johonkanen/ac_psu_gate_drive/source/schematic_pdf/schematic_text.txt

                                                               drv1_vcc

                                           DRV1
                                       1                        8
pwm_hi                                      Vin        VDD2
                                                                     D1+
                                                                            R12
                                       2                        7
            5v                              VDD1       OUT+                22R
                                                                                                       Gate_HI
            R1                         3
                                            GND1        OUT-
                                                                6    D1-
                                                                            R2
            10k        C6
                       100n                                                3R
                                       4                        5
                                            EN         GND2
                                                                                                 R6                                    J9
                                                                                                 10k
                                                                                                                                  16          15
                                           SI8271
                                                                                                                                  18          17
                                                                                                                 SOURCE_HI                                SOURCE_HI
                                 GND                                                                                              20          19
                                                    DRV1_RET
                                                                                                                                  22          21
                                                                                                                                  24          23
                                                                                                                   GATE_HI                                GATE_HI
                                                                                                                                  26          25

                                                               drv2_vcc                                                           30          29
                                                                                  SOURCE_HI
                                                                                                                                  32          31
                                           DRV2                                                                       Source_LO                           Source_LO
                                                                                                                                  34          33
                                                                                                                                  36          35
                                       1                        8
   pwm_lo                                   Vin        VDD2                                                                       38          37
                                                                                                                       Gate_LO                            Gate_LO
                                                                     D2+
                                                                           R4                                                     40          39
                                       2                        7
             5v                             VDD1       OUT+                22R                                                    44          43
                                                                                                       Gate_LO        PWM_HI                             PWM_LO
                                                                          R5                                                      46          45
                 R3                    3
                                            GND1        OUT-
                                                                6     D2-                                                 5v
                                                                                                                                  48          47
                                                                                                                                                         GND
                 10k          C5                                                                                   PWM_TRANS                             15V
                              100n                                         3R
                                       4                        5                                                                      HB GT CONNECTOR
                                            EN         GND2
                                                                                                 R8
                                           SI8271                                                10k

                                 GND

                                                               DRV2_RET
                                                                                     SOURCE_LO

                                                        DRV1_VCC
                  J3            D3
                          1

                  PIN           ZLLS400TA
                                                   D7            C1
                                                               4.7u
                  J5                               MMSZ5228BS-7-F
                          1                                                                                       R9
                                                                                             SOURCE_HI            10k
                  PIN
                                                   D8            C2
                  J4           D4                              4.7u
                                                   MMSZ5228BS-7-F
                          1

                  PIN          ZLLS400TA

                                                        DRV1_RET

                                                        DRV2_VCC
                  J6           D1
                          1                                                                                                            gate power supply transformer
                  PIN          ZLLS400TA
                                                                                                                                        toroid 10/6/4
                                                D6               C4                                                                                       12t   J3
                                                                 4.7u
                  J8                            MMSZ5228BS-7-F
                          1
                                                                                             SOURCE_LO            R10
                                                                                                                  10k                                           J4
                  PIN
                                           D5                    C3
                  J7          D2                                 4.7u                                                                  J1
                                           MMSZ5228BS-7-F                                                                                      8t
                          1
                                                                                                                                                           4t   J5
                  PIN         ZLLS400TA
                                                        DRV2_RET                                                                                          12t
                                                                                                                                       J2                       J6

                                                                                                                                                                J7
                                                                                                                                                          4t
            15V                                                                                                                                                 J8
                                                                                                           DRV3
                                                                             8

                                                                                         1
                                                                                 VCC

                                                                                             VCC

                                                                                                                      J1
                                                                  2                                         7     1
pwm_trans                                                               IN                          OUTA                        J2
                                                                                                                      PIN       PIN

                                                                                                                            1
                                                                  3                                         6
                                            R11                         EN                          OUTB
                                                                             GND
                                                                                       GND

                   C7         C8
                                                                                              TAB

                                            10k
                   4.7u       100n                                                                                              C12
                                                                                                    IXDD609D2TR                 100n
                                                                             4
                                                                                   5
                                                                                             9

            GND
