johonkanen/ac_psu_gate_drive/dcm/reference/pins_by_net.md

# Pins by net

Generated by `p2k ipc356`. Do not edit. Nets with a single pin are
usually test points or connections made through the ignored-by-IPC copper.

`vias` counts vias and free pads (blank refdes with a net).

| net | pins | vias | members |
|---|---|---|---|
| 5V | 7 | 0 | C5-2 C6-2 DRV1-2 DRV1-4 DRV2-2 DRV2-4 J9-46 |
| 15V | 5 | 2 | C8-2 C9-1 J1-1 J9-47 R14-1 |
| #00038 | 2 | 0 | D1-A J6-1 |
| #00039 | 2 | 0 | D2-C J7-1 |
| #00040 | 2 | 0 | D3-A J3-1 |
| #00041 | 2 | 0 | D4-C J4-1 |
| #00043 | 3 | 0 | J2-1 Q1-3 R7-2 |
| #00046 | 2 | 0 | Q1-1 R11-2 |
| #00047 | 3 | 0 | C9-2 D9-C R14-2 |
| #00048 | 2 | 0 | D9-A R7-1 |
| D1+ | 2 | 0 | DRV1-7 R12-1 |
| D1- | 2 | 0 | DRV1-6 R2-1 |
| D2+ | 2 | 0 | DRV2-7 R4-1 |
| D2- | 2 | 0 | DRV2-6 R5-1 |
| DRV1_RET | 5 | 2 | C2-2 D4-A D8-A DRV1-5 R9-2 |
| DRV1_VCC | 6 | 2 | C1-1 D3-C D7-C DRV1-8 J9-26 R9-1 |
| DRV2_RET | 5 | 2 | C3-2 D2-A D5-A DRV2-5 R10-2 |
| DRV2_VCC | 6 | 2 | C4-1 D1-C D6-C DRV2-8 J9-40 R10-1 |
| GATE_HI | 8 | 0 | J9-21 J9-22 J9-23 J9-24 J9-25 R2-2 R6-1 R12-2 |
| GATE_LO | 8 | 0 | J9-35 J9-36 J9-37 J9-38 J9-39 R4-2 R5-2 R8-1 |
| GND | 10 | 3 | C5-1 C6-1 C8-1 DRV1-3 DRV2-3 J9-45 Q1-2 R1-2 R3-2 R13-2 |
| PWM_HI | 3 | 1 | DRV1-1 J9-44 R1-1 |
| PWM_LO | 3 | 0 | DRV2-1 J9-43 R3-1 |
| PWM_TRANS | 3 | 0 | J9-48 R11-1 R13-1 |
| SOURCE_HI | 12 | 1 | C1-2 C2-1 D7-A D8-C J5-1 J9-15 J9-16 J9-17 J9-18 J9-19 J9-20 R6-2 |
| SOURCE_LO | 12 | 1 | C3-1 C4-2 D5-C D6-A J8-1 J9-29 J9-30 J9-31 J9-32 J9-33 J9-34 R8-2 |
