johonkanen/ac_psu_gate_drive/dcm/reports/render/01_gate_drivers.png

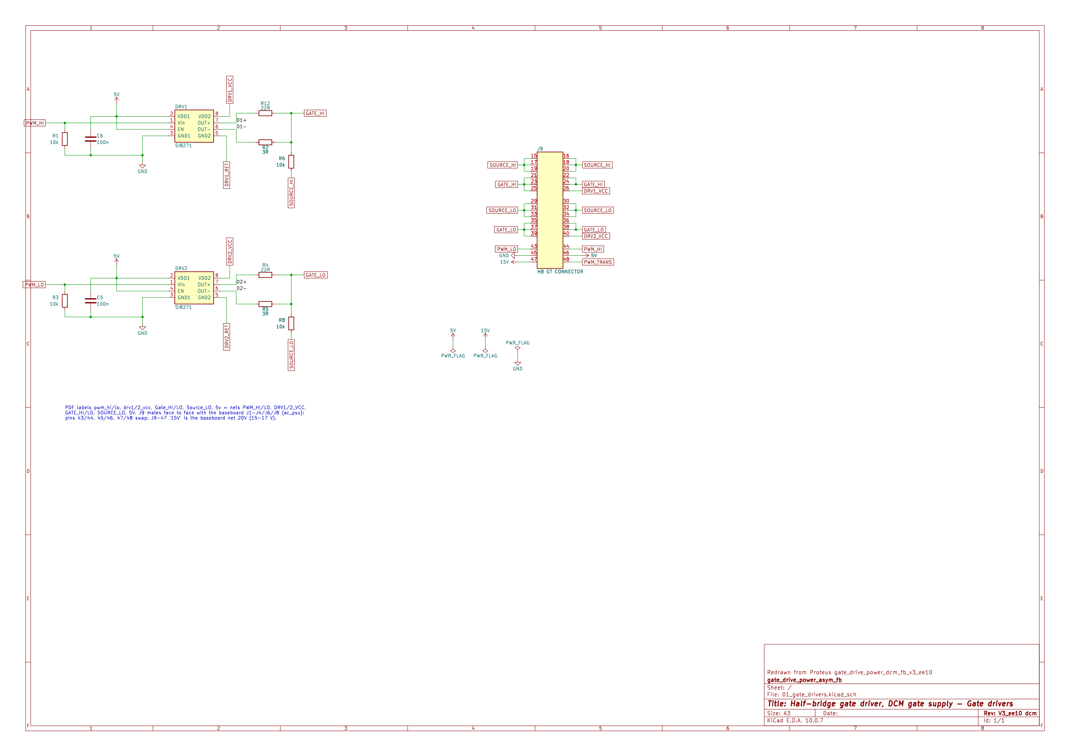
dcm/reports/render/01_gate_drivers.png
