johonkanen/ac_psu_gate_drive/dcm/reports/render/02_gate_supply.png

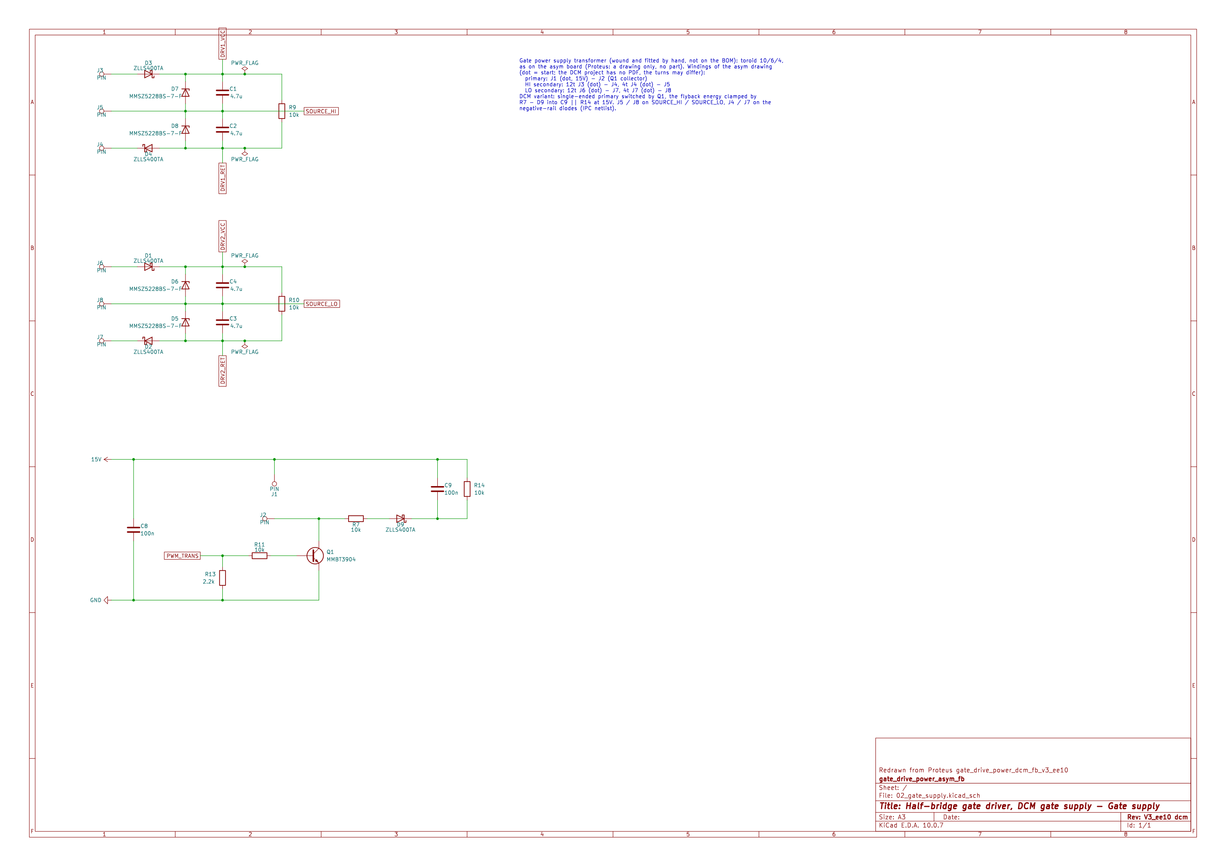
dcm/reports/render/02_gate_supply.png
