johonkanen/ac_psu_gate_drive/dcm/reports/roundtrip/B_Cu.png

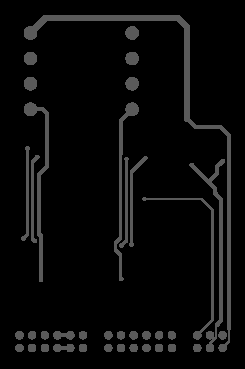
dcm/reports/roundtrip/B_Cu.png
