johonkanen/ac_psu_gate_drive/dcm/reports/roundtrip/F_Cu.png

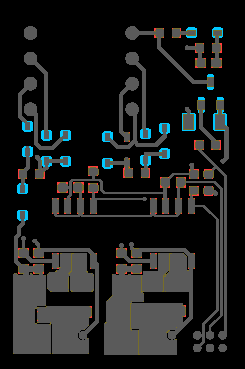
dcm/reports/roundtrip/F_Cu.png
