johonkanen/ac_psu_gate_drive/source/schematic_pdf/hi-1.png

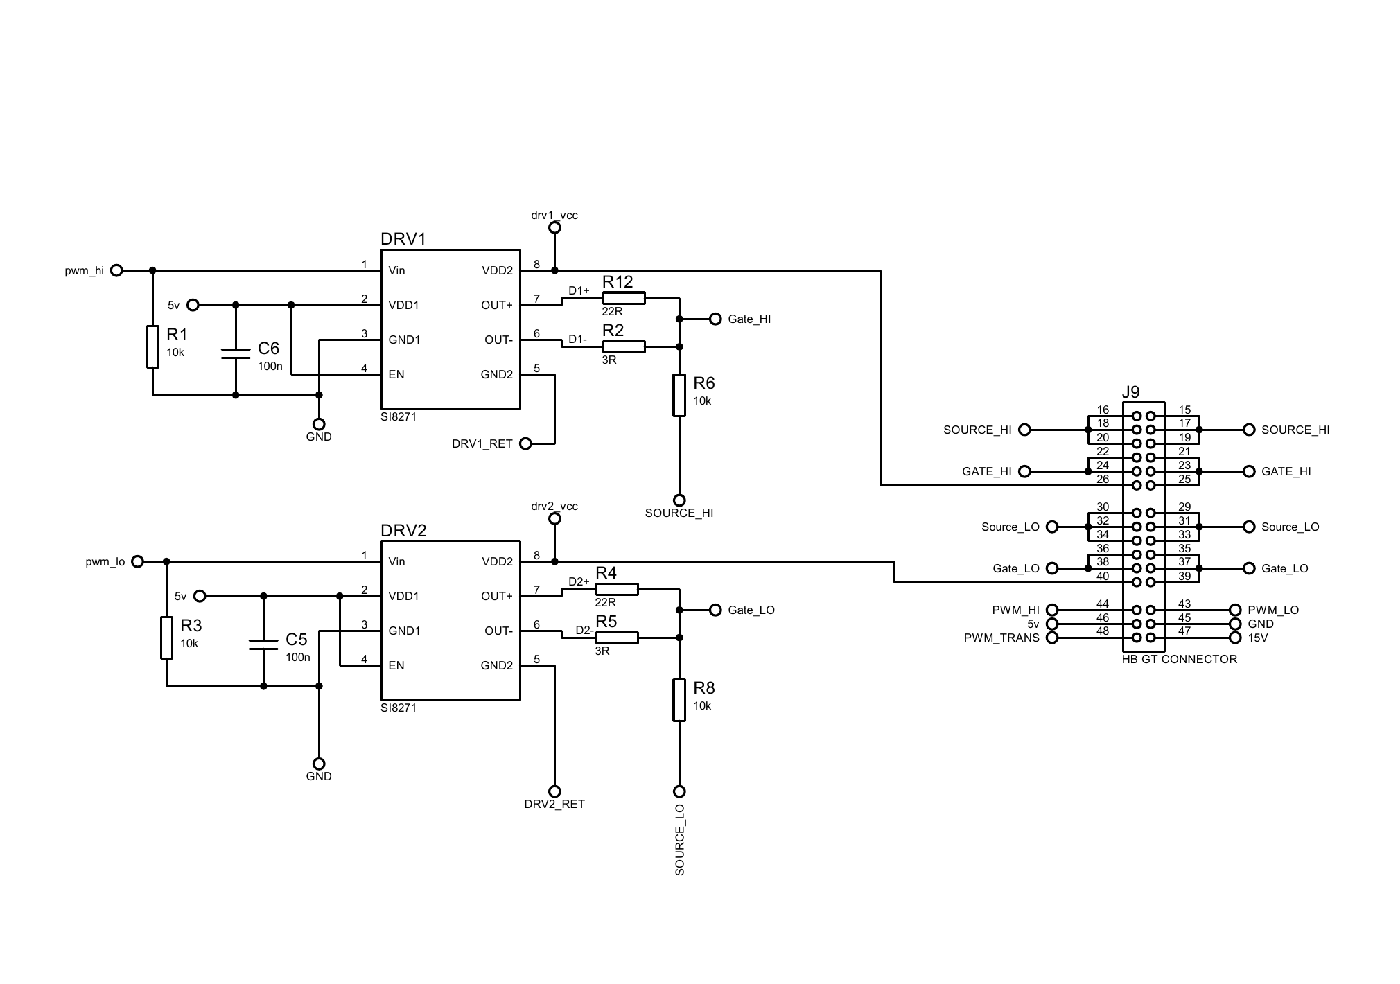
source/schematic_pdf/hi-1.png
