johonkanen/ac_psu_gate_drive/source/schematic_pdf/hi-2.png

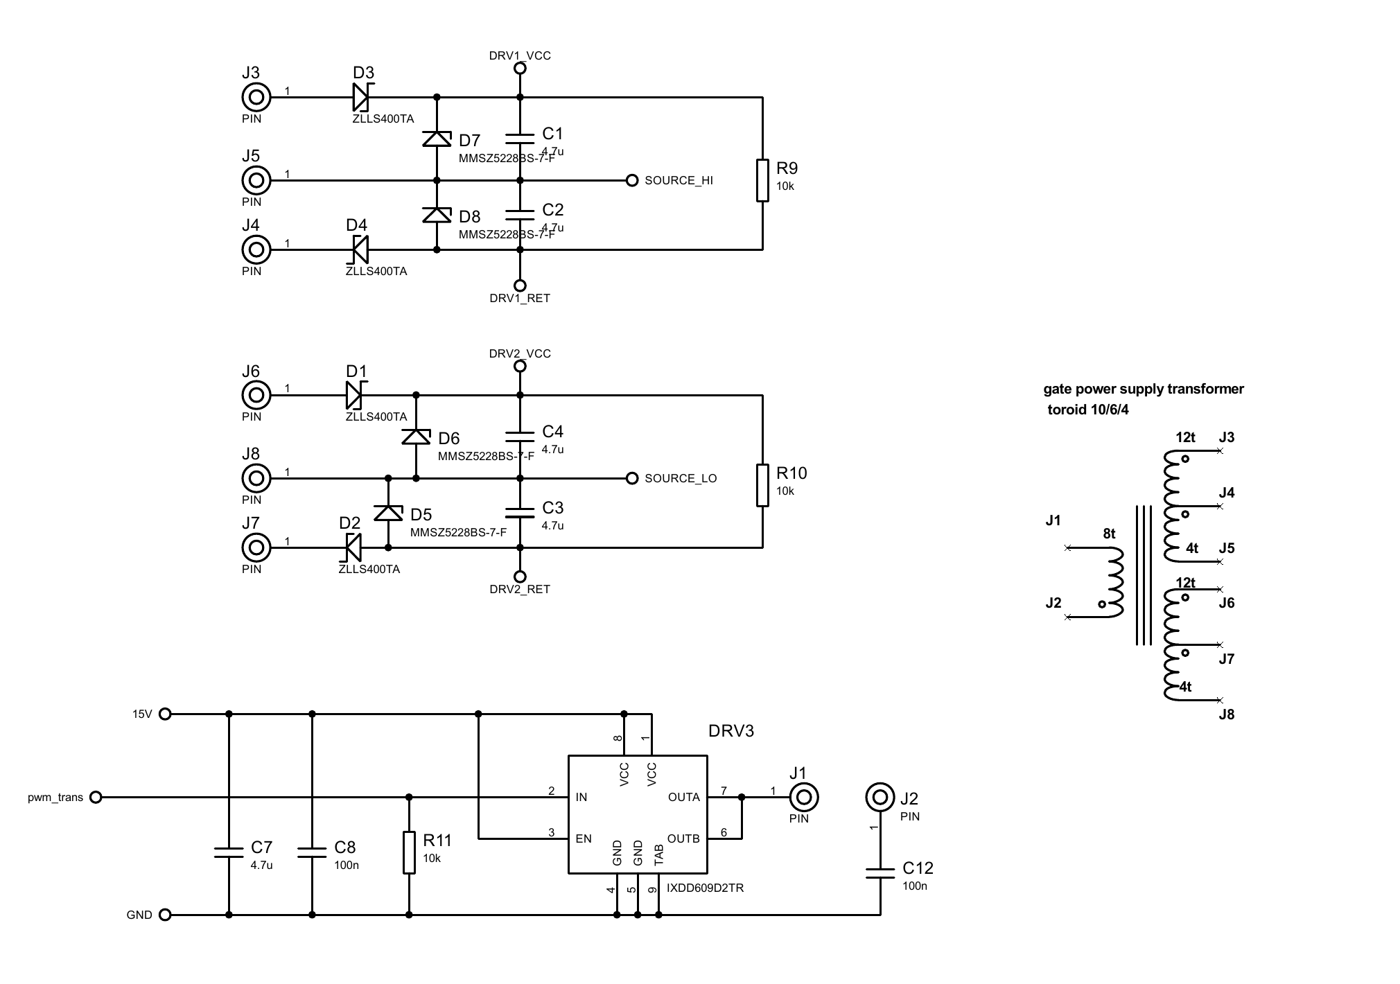
source/schematic_pdf/hi-2.png
