johonkanen/ac_psu_gate_drive/dcm/reference/pin_nets_by_component.md

# Pin → net by component

Generated by `p2k ipc356` from the Proteus IPC-D-356A netlist. Do not edit.

Net aliases: .
Refdes restored from 6-char truncation: .
`N/C` = explicitly unconnected in Proteus; `(no net)` = pad without any net record.
Coordinates in mm, IPC orientation (Y up). Side: top/bottom for SMD, both for THT.

Index: C (8), D (9), DRV (2), J (9), Q (1), R (14)

## C1

2 pads, SMD, side top

| pin | net | x | y |
|---|---|---|---|
| 1 | DRV1_VCC | -20.400 | 16.700 |
| 2 | SOURCE_HI | -20.400 | 15.100 |

## C2

2 pads, SMD, side top

| pin | net | x | y |
|---|---|---|---|
| 1 | SOURCE_HI | -21.900 | 15.100 |
| 2 | DRV1_RET | -21.900 | 16.700 |

## C3

2 pads, SMD, side top

| pin | net | x | y |
|---|---|---|---|
| 1 | SOURCE_LO | -12.100 | 15.100 |
| 2 | DRV2_RET | -12.100 | 16.700 |

## C4

2 pads, SMD, side top

| pin | net | x | y |
|---|---|---|---|
| 1 | DRV2_VCC | -10.600 | 16.700 |
| 2 | SOURCE_LO | -10.600 | 15.100 |

## C5

2 pads, SMD, side top

| pin | net | x | y |
|---|---|---|---|
| 1 | GND | -18.017 | 23.232 |
| 2 | 5V | -16.417 | 23.232 |

## C6

2 pads, SMD, side top

| pin | net | x | y |
|---|---|---|---|
| 1 | GND | -7.755 | 23.790 |
| 2 | 5V | -6.155 | 23.790 |

## C8

2 pads, SMD, side top

| pin | net | x | y |
|---|---|---|---|
| 1 | GND | -2.250 | 29.800 |
| 2 | 15V | -5.400 | 29.800 |

## C9

2 pads, SMD, side top

| pin | net | x | y |
|---|---|---|---|
| 1 | 15V | -4.200 | 35.700 |
| 2 | #00047 | -2.600 | 35.700 |

## D1

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

## R13

2 pads, SMD, side top

| pin | net | x | y |
|---|---|---|---|
| 1 | PWM_TRANS | -3.400 | 24.600 |
| 2 | GND | -3.400 | 22.872 |

## R14

2 pads, SMD, side top

| pin | net | x | y |
|---|---|---|---|
| 1 | 15V | -4.300 | 37.200 |
| 2 | #00047 | -2.572 | 37.200 |
