johonkanen/ac_psu_gate_drive/dcm/fab/jlc_bom.csv

Comment | Designator | Footprint | JLCPCB Part #
10k | R1,R3,R6,R7,R8,R9,R10,R11,R14 | 0603 | C25804
2.2k | R13 | 0603 | C4190
22R | R4,R12 | 1206 | C17958
3R | R2,R5 | 1206 | C17939
100nF 50V X7R | C5,C6,C9 | 0603 | C14663
4.7uF 25V X5R | C1,C2,C3,C4 | 0603 | C5360844
100nF 50V X7R | C8 | 1206 | C24497
ZLLS400TA | D1,D2,D3,D4,D9 | SOD-323 | C460267
MMSZ5228BS-7-F | D5,D8 | SOD-323 | C2895358
MMSZ5246BS-7-F | D6,D7 | SOD-323 | C151819
MMBT3904 | Q1 | SOT-23 | C20526
SI8271DB-ISR | DRV1,DRV2 | SOIC-8 | C461855
