johonkanen/ac_psu_gate_drive/dcm/reports/footprint_fit.csv

# IPC frame (mm | Y up): board = (x | y) + R(angle) . M . pad | M = mirror x for bottom. KiCad (Y down): SetPosition(kicad_x | kicad_y); bottom: Flip(pos | LEFT_RIGHT); then SetOrientationDegrees(kicad_orientation)
refdes | footprint | side | angle | x | y | kicad_x | kicad_y | kicad_orientation | max_residual | max_pad_size_diff | max_drill_diff | max_pad_axis_diff
C1 | Capacitor_SMD:C_0603_1608Metric | top | 270 | -20.4000 | 15.9000 | -20.4000 | -15.9000 | 270 | 0.0250 | 0.040 | 0.000 | 0
C2 | Capacitor_SMD:C_0603_1608Metric | top | 90 | -21.9000 | 15.9000 | -21.9000 | -15.9000 | 90 | 0.0250 | 0.040 | 0.000 | 0
C3 | Capacitor_SMD:C_0603_1608Metric | top | 90 | -12.1000 | 15.9000 | -12.1000 | -15.9000 | 90 | 0.0250 | 0.040 | 0.000 | 0
C4 | Capacitor_SMD:C_0603_1608Metric | top | 270 | -10.6000 | 15.9000 | -10.6000 | -15.9000 | 270 | 0.0250 | 0.040 | 0.000 | 0
C5 | Capacitor_SMD:C_0603_1608Metric | top | 0 | -17.2170 | 23.2320 | -17.2170 | -23.2320 | 0 | 0.0250 | 0.040 | 0.000 | 0
C6 | Capacitor_SMD:C_0603_1608Metric | top | 0 | -6.9550 | 23.7900 | -6.9550 | -23.7900 | 0 | 0.0250 | 0.040 | 0.000 | 0
C8 | Capacitor_SMD:C_1206_3216Metric_Pad1.33x1.80mm_HandSolder | top | 180 | -3.8250 | 29.8000 | -3.8250 | -29.8000 | 180 | 0.0125 | 0.309 | 0.000 | 0
C9 | Capacitor_SMD:C_0603_1608Metric | top | 0 | -3.4000 | 35.7000 | -3.4000 | -35.7000 | 0 | 0.0250 | 0.040 | 0.000 | 0
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
R8 | Resistor_SMD:R_0603_1608Metric | top | 180 | -11.2360 | 9.8000 | -11.2360 | -9.8000 | 180 | 0.0390 | 0.089 | 0.000 | 0
R9 | Resistor_SMD:R_0603_1608Metric | top | 180 | -21.1360 | 24.6000 | -21.1360 | -24.6000 | 180 | 0.0390 | 0.089 | 0.000 | 0
