johonkanen/ac_psu_gate_drive/dcm/reports/footprint_pads.csv

refdes | pad | residual | ipc_x | ipc_y | ipc_size | fp_size | d_long | d_short | axis_diff | ipc_drill | fp_drill
C1 | 1 | 0.0250 | -20.400 | 16.700 | 0.939x0.99 | 0.9x0.95 | -0.040 | -0.039 | 0
C1 | 2 | 0.0250 | -20.400 | 15.100 | 0.939x0.99 | 0.9x0.95 | -0.040 | -0.039 | 0
C2 | 1 | 0.0250 | -21.900 | 15.100 | 0.939x0.99 | 0.9x0.95 | -0.040 | -0.039 | 0
C2 | 2 | 0.0250 | -21.900 | 16.700 | 0.939x0.99 | 0.9x0.95 | -0.040 | -0.039 | 0
C3 | 1 | 0.0250 | -12.100 | 15.100 | 0.939x0.99 | 0.9x0.95 | -0.040 | -0.039 | 0
C3 | 2 | 0.0250 | -12.100 | 16.700 | 0.939x0.99 | 0.9x0.95 | -0.040 | -0.039 | 0
C4 | 1 | 0.0250 | -10.600 | 16.700 | 0.939x0.99 | 0.9x0.95 | -0.040 | -0.039 | 0
C4 | 2 | 0.0250 | -10.600 | 15.100 | 0.939x0.99 | 0.9x0.95 | -0.040 | -0.039 | 0
C5 | 1 | 0.0250 | -18.017 | 23.232 | 0.939x0.99 | 0.9x0.95 | -0.040 | -0.039 | 0
C5 | 2 | 0.0250 | -16.417 | 23.232 | 0.939x0.99 | 0.9x0.95 | -0.040 | -0.039 | 0
C6 | 1 | 0.0250 | -7.755 | 23.790 | 0.939x0.99 | 0.9x0.95 | -0.040 | -0.039 | 0
C6 | 2 | 0.0250 | -6.155 | 23.790 | 0.939x0.99 | 0.9x0.95 | -0.040 | -0.039 | 0
C8 | 1 | 0.0125 | -2.250 | 29.800 | 1.016x1.524 | 1.325x1.8 | +0.276 | +0.309 | 0
C8 | 2 | 0.0125 | -5.400 | 29.800 | 1.016x1.524 | 1.325x1.8 | +0.276 | +0.309 | 0
C9 | 1 | 0.0250 | -4.200 | 35.700 | 0.939x0.99 | 0.9x0.95 | -0.040 | -0.039 | 0
C9 | 2 | 0.0250 | -2.600 | 35.700 | 0.939x0.99 | 0.9x0.95 | -0.040 | -0.039 | 0
D1 | A | 0.0000 | -9.700 | 28.600 | 0.508x0.838 | 1x1 | +0.162 | +0.492
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
R8 | 2 | 0.0390 | -12.100 | 9.800 | 0.889x0.889 | 0.8x0.95 | +0.061 | -0.089
R9 | 1 | 0.0390 | -20.272 | 24.600 | 0.889x0.889 | 0.8x0.95 | +0.061 | -0.089
R9 | 2 | 0.0390 | -22.000 | 24.600 | 0.889x0.889 | 0.8x0.95 | +0.061 | -0.089
