johonkanen/ac_psu_gate_drive/source/schematic_pdf/gate_drive_power_asym_fb_v3_ee10.PDF

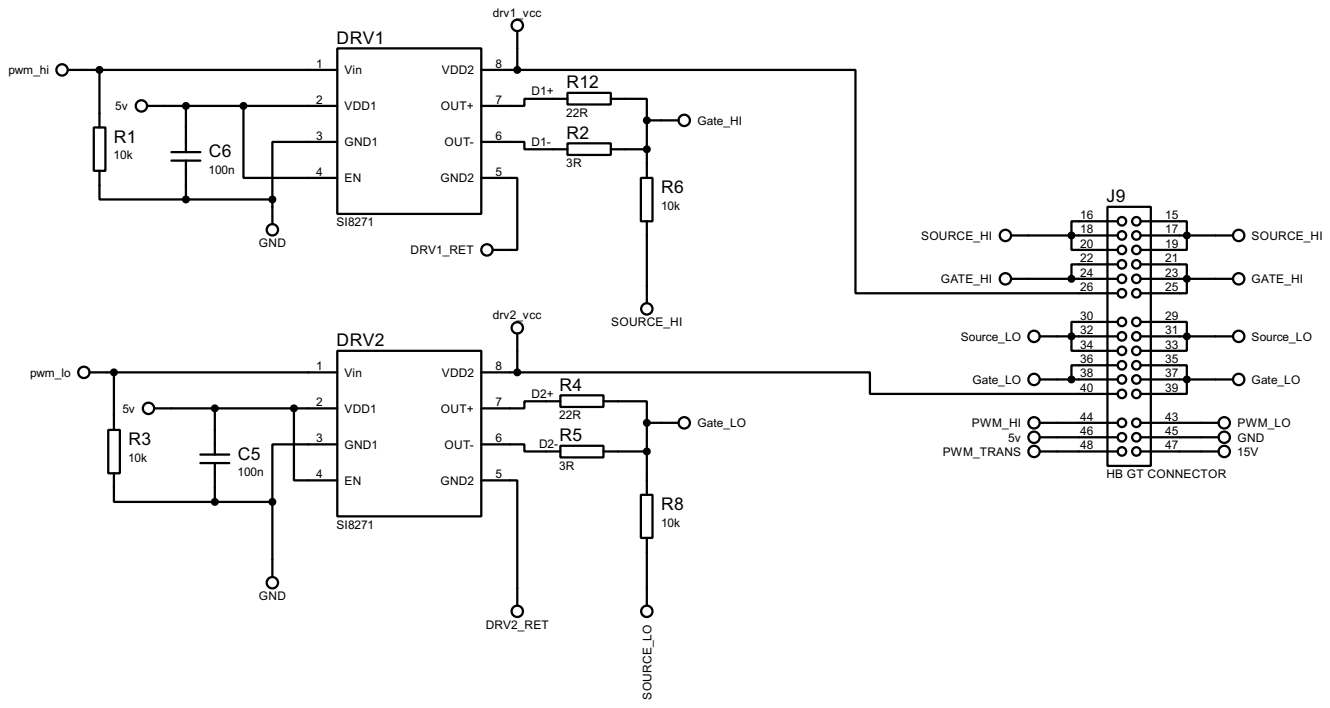
[picture p7: page 1]

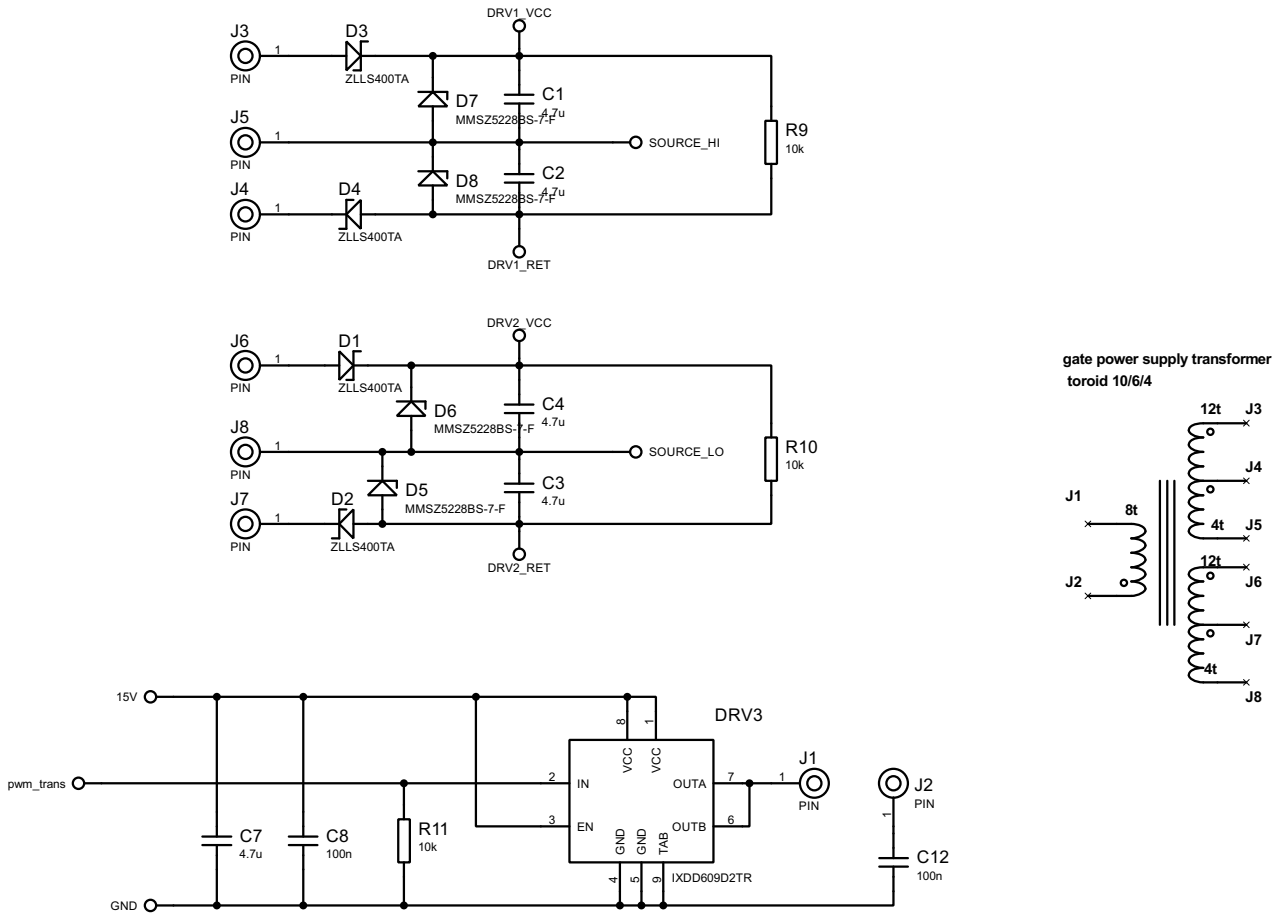
[picture p8: page 2]
