johonkanen/ac_psu_gate_drive/(list of files, drawings)

Other design files:
dcm/source/gate_drive_power_dcm_fb_v3_ee10.pdsprj
source/gate_drive_power_asym_fb_v3_ee10.pdsprj
