johonkanen/ac_psu_gate_drive/dcm/kicad/gate_drive.kicad_pcb

## KiCad design dcm/kicad/gate_drive.kicad_pcb (2026-11-05)

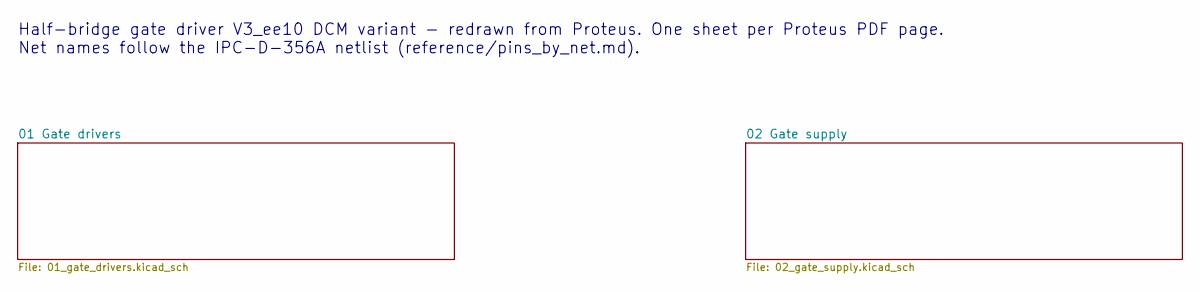
[picture p9: schematic gate_drive.kicad_sch, Half-bridge gate driver, DCM gate supply]

Notes on the sheet:
Half-bridge gate driver V3_ee10 DCM variant - redrawn from Proteus. One sheet per Proteus PDF page. Net names follow the IPC-D-356A netlist (reference/pins_by_net.md).

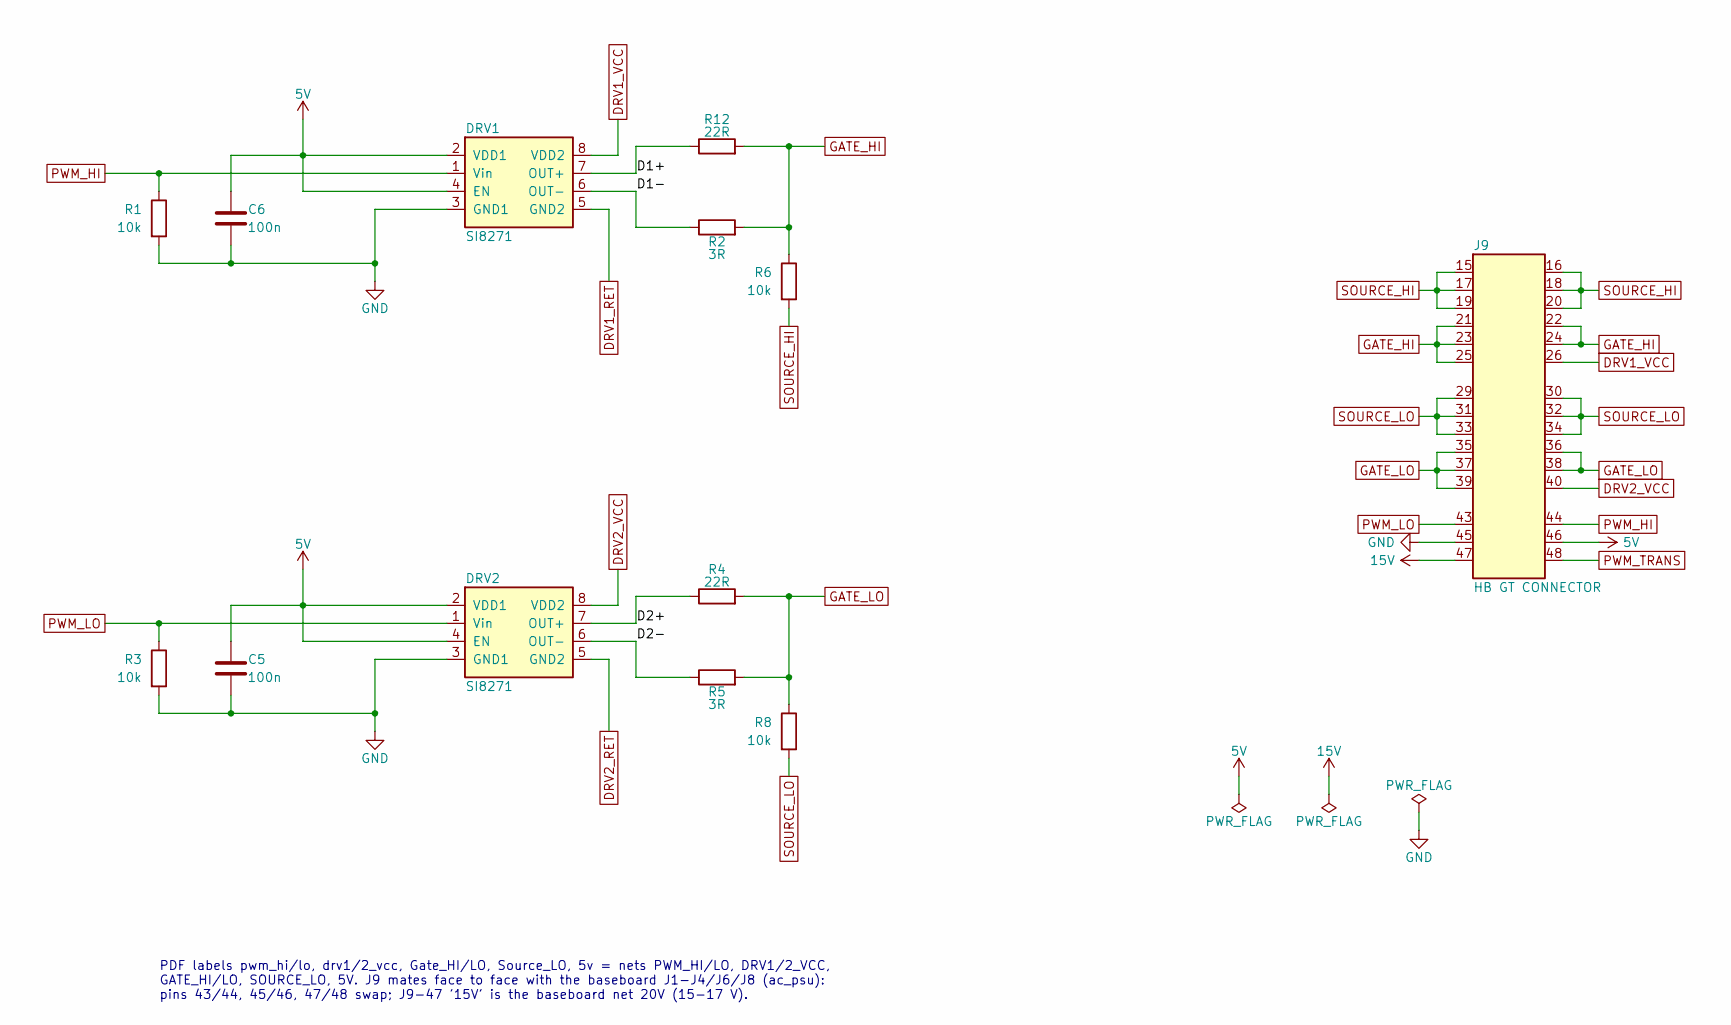
[picture p10: schematic 01_gate_drivers.kicad_sch, Half-bridge gate driver, DCM gate supply - Gate drivers]

Parts:
C5, C6: 100n; C_0603_1608Metric
DRV1, DRV2: SI8271; SOIC-8_3.9x4.9mm_P1.27mm_Proteus
J9: HB GT CONNECTOR; PinHeader_2x24_P1.27mm_Vertical_Pins15-48
R1, R3, R6, R8: 10k; R_0603_1608Metric
R2, R5: 3R; R_1206_3216Metric
R4, R12: 22R; R_1206_3216Metric

Connections:
5V: C5.2, C6.2, DRV1.2 (VDD1), DRV1.4 (EN), DRV2.2 (VDD1), DRV2.4 (EN), J9.46
15V: J9.47; also elsewhere on the board
/01 Gate drivers/D1+: DRV1.7 (OUT+), R12.1
/01 Gate drivers/D1-: DRV1.6 (OUT-), R2.1
/01 Gate drivers/D2+: DRV2.7 (OUT+), R4.1
/01 Gate drivers/D2-: DRV2.6 (OUT-), R5.1
DRV1_RET: DRV1.5 (GND2); also elsewhere on the board
DRV1_VCC: DRV1.8 (VDD2), J9.26; also elsewhere on the board
DRV2_RET: DRV2.5 (GND2); also elsewhere on the board
DRV2_VCC: DRV2.8 (VDD2), J9.40; also elsewhere on the board
GATE_HI: J9.21, J9.22, J9.23, J9.24, J9.25, R2.2, R6.1, R12.2
GATE_LO: J9.35, J9.36, J9.37, J9.38, J9.39, R4.2, R5.2, R8.1
GND: C5.1, C6.1, DRV1.3 (GND1), DRV2.3 (GND1), J9.45, R1.2, R3.2; also elsewhere on the board
PWM_HI: DRV1.1 (Vin), J9.44, R1.1
PWM_LO: DRV2.1 (Vin), J9.43, R3.1
PWM_TRANS: J9.48; also elsewhere on the board
SOURCE_HI: J9.15, J9.16, J9.17, J9.18, J9.19, J9.20, R6.2; also elsewhere on the board
SOURCE_LO: J9.29, J9.30, J9.31, J9.32, J9.33, J9.34, R8.2; also elsewhere on the board

Notes on the sheet:
PDF labels pwm_hi/lo, drv1/2_vcc, Gate_HI/LO, Source_LO, 5v = nets PWM_HI/LO, DRV1/2_VCC, GATE_HI/LO, SOURCE_LO, 5V. J9 mates face to face with the baseboard J1-J4/J6/J8 (ac_psu): pins 43/44, 45/46, 47/48 swap; J9-47 '15V' is the baseboard net 20V (15-17 V).

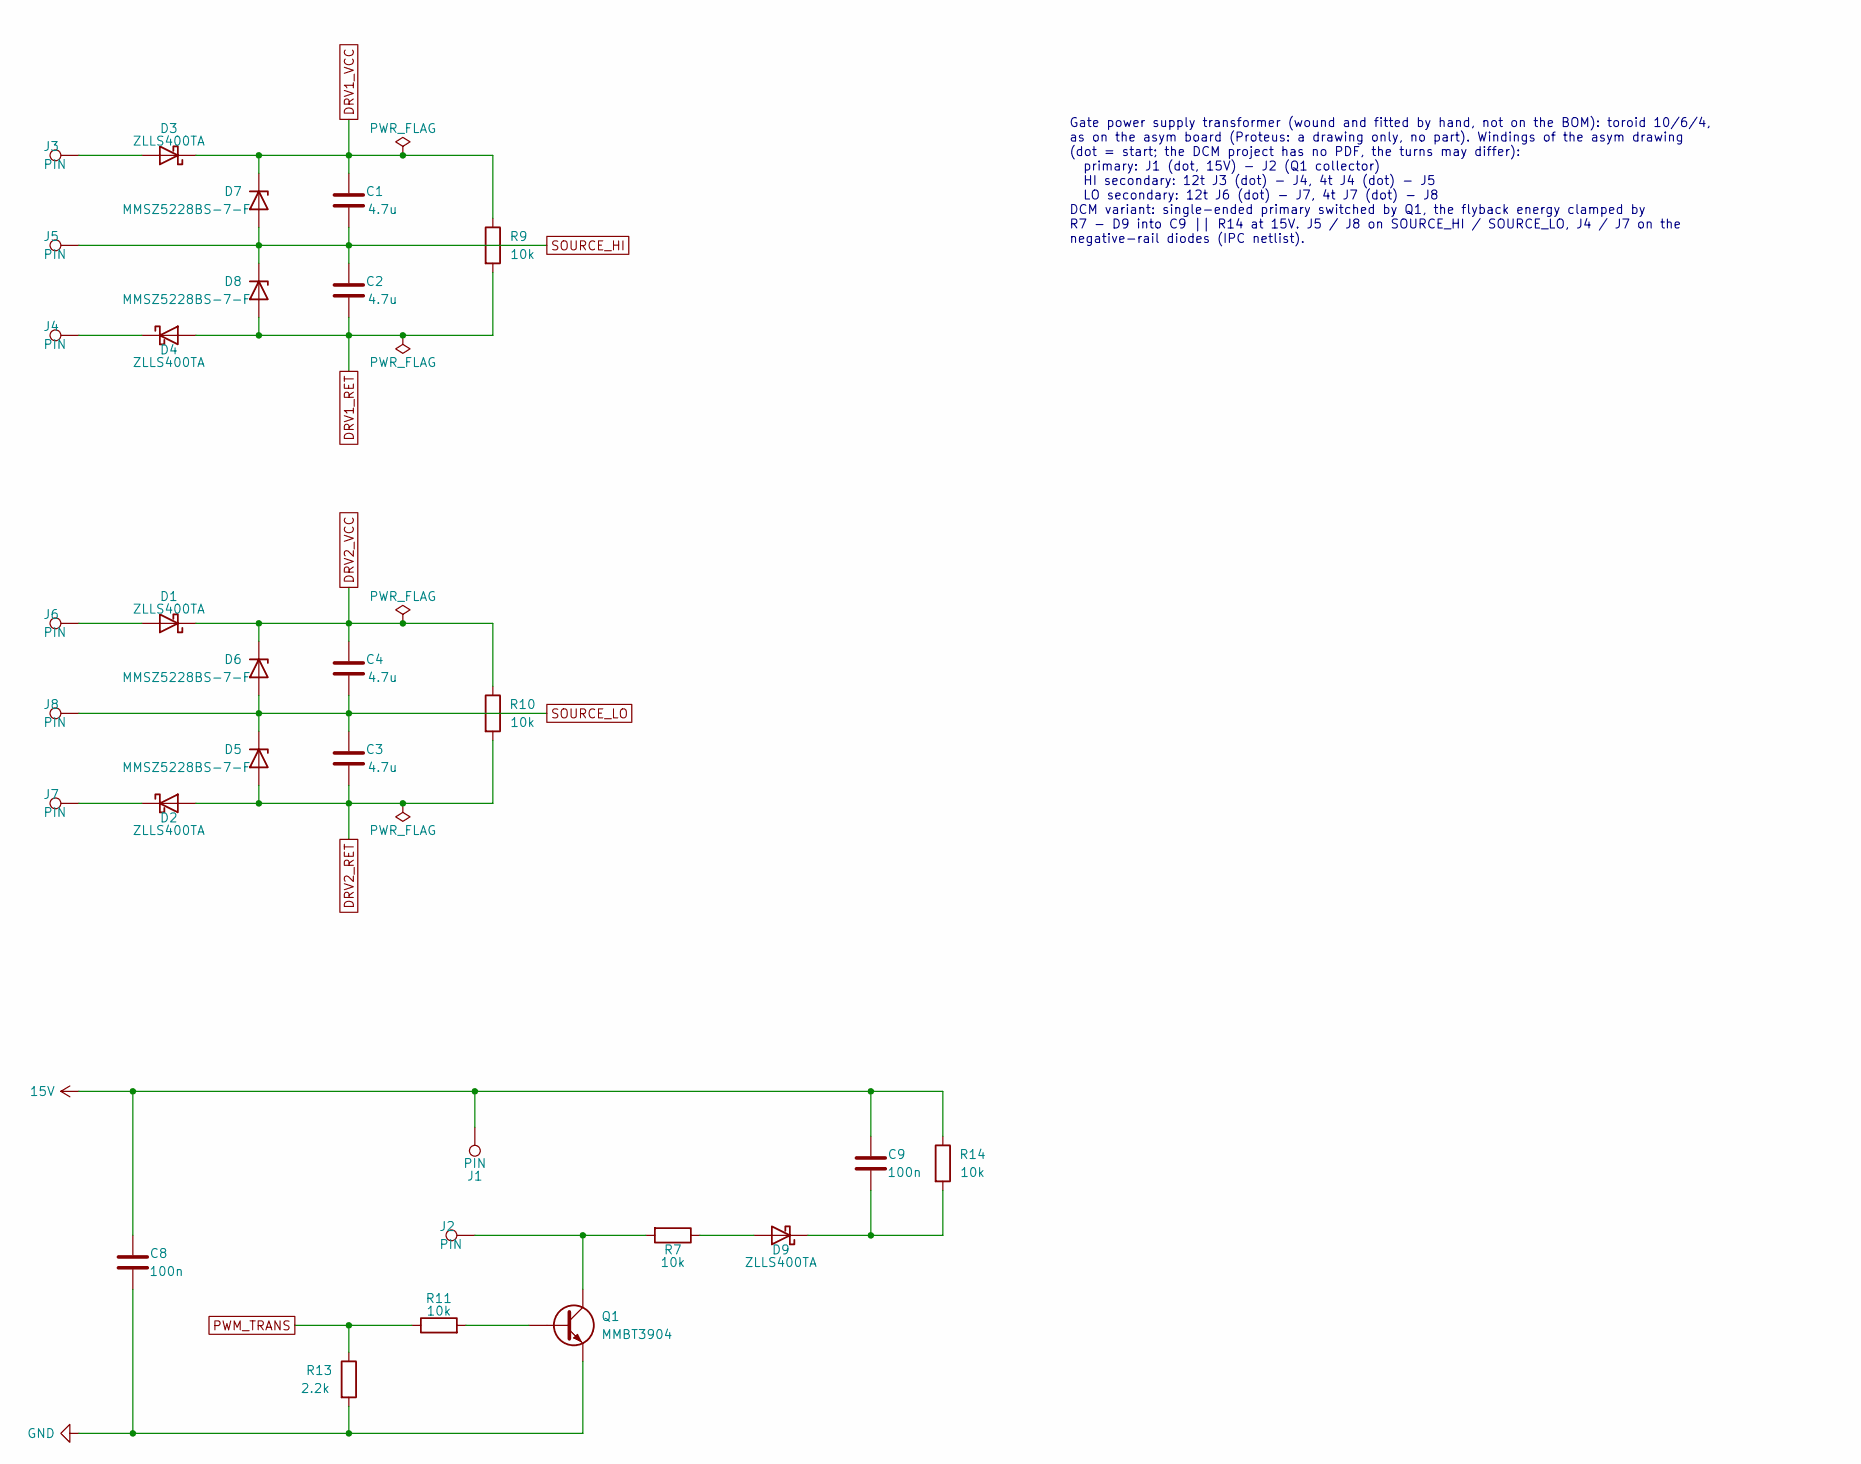
[picture p11: schematic 02_gate_supply.kicad_sch, Half-bridge gate driver, DCM gate supply - Gate supply]

Parts:
C1, C2, C3, C4: 4.7u; C_0603_1608Metric
C8: 100n; C_1206_3216Metric_Pad1.33x1.80mm_HandSolder
C9: 100n; C_0603_1608Metric
D1, D3, D4, D9: ZLLS400TA; D_SOD-323_AC
D2: ZLLS400TA; D_SOD-323_AC_Proteus
D5, D6, D7, D8: MMSZ5228BS-7-F; D_SOD-323_AC
J1, J2, J3, J4, J5, J6, J7, J8: PIN; WirePad_D1.27mm_Drill0.762mm
Q1: MMBT3904; SOT-23_Proteus
R7, R9, R10, R11, R14: 10k; R_0603_1608Metric
R13: 2.2k; R_0603_1608Metric

Connections:
15V: C8.2, C9.1, J1.1, R14.1; also elsewhere on the board
DRV1_RET: C2.2, D4.A, D8.A, R9.2; also elsewhere on the board
DRV1_VCC: C1.1, D3.C (K), D7.C (K), R9.1; also elsewhere on the board
DRV2_RET: C3.2, D2.A, D5.A, R10.2; also elsewhere on the board
DRV2_VCC: C4.1, D1.C (K), D6.C (K), R10.1; also elsewhere on the board
GND: C8.1, Q1.2 (E), R13.2; also elsewhere on the board
unnamed: D1.A, J6.1
unnamed: D2.C (K), J7.1
unnamed: D3.A, J3.1
unnamed: D4.C (K), J4.1
unnamed: C9.2, D9.C (K), R14.2
unnamed: D9.A, R7.1
unnamed: Q1.1 (B), R11.2
unnamed: J2.1, Q1.3 (C), R7.2
PWM_TRANS: R11.1, R13.1; also elsewhere on the board
SOURCE_HI: C1.2, C2.1, D7.A, D8.C (K), J5.1; also elsewhere on the board
SOURCE_LO: C3.1, C4.2, D5.C (K), D6.A, J8.1; also elsewhere on the board

Notes on the sheet:
Gate power supply transformer (wound and fitted by hand, not on the BOM): toroid 10/6/4, as on the asym board (Proteus: a drawing only, no part). Windings of the asym drawing (dot = start; the DCM project has no PDF, the turns may differ): primary: J1 (dot, 15V) - J2 (Q1 collector) HI secondary: 12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

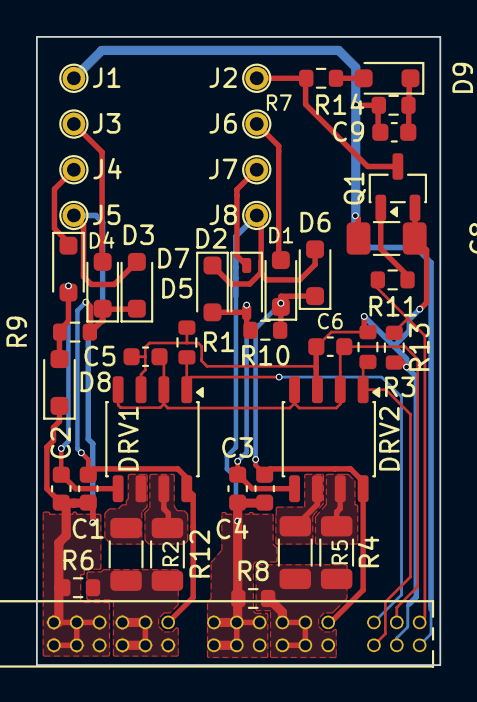
[picture p12: board gate_drive.kicad_pcb from above]

Board: 2 copper layers, 22.4 x 34.9 mm, 43 parts (0 on the bottom side), 26 nets.
