johonkanen/ac_psu_gate_drive/(commit log)

2026-11-03 Proteus -> KiCad conversion of gate_drive_power_asym_fb_v3_ee10, phases 0-4 + JLC files
    Phase 0: sources, p2k_config.py, IPC reference (24 nets, 136 records, 40 parts, 17 vias), X2 vs IPC.
    Phase 1: part map, symbols, 2 sheets (40/40 parts, 0 wrong-net pins, ERC 0 errors).
    Phase 2: footprints, every part within 0.039 mm of the IPC pads.
    Phase 3: board rebuilt from the gerbers (0 shorts/orphans/opens, DRC 0 shorts/unconnected/parity;
    Proteus pads on DRV1, DRV2, J9, D2).
    Phase 4: ipc356_diff 136/136, 0 mismatches; gerber round trip only pad-shape clusters.
    fab/: JLC BOM (30 SMD parts, all in stock for 5 boards), CPL, hand-fit list (toroid, DRV3, J9).
    Findings in STATUS.md (D6/D7 3.9 V zener on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
    [01_gate_drivers.kicad_sch, 02_gate_supply.kicad_sch, footprint_fit.csv, footprint_pads.csv, gate_drive.kicad_pcb, gate_drive.kicad_sch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]
2026-11-03 D6/D7 16 V zeners in the JLC BOM (user rails +14.5..16 V / -3..-4.5 V); repo johonkanen/ac_psu_gate_drive
    D6/D7 clamp the positive gate rail: MMSZ5228BS (3.9 V) -> MMSZ5246BS-7-F (16 V, C151819) in
    fab/jlc_bom.csv; schematic keeps the Proteus value (first deviation, later with a deviation list).
    D5/D8 stay 3.9 V. Si8271 variant: DB suggested (17.5-20.5 V VDD2-GND2), AB kept until confirmed.
    Claude-Session: https://claude.ai/code/session_01Am5hpeWpvZbzmHWspFiWJm
    [jlc_bom.csv]
2026-11-03 fab: SI8271DB-ISR (C461855) for DRV1/DRV2 (user); stocked SOIC-8 alternatives for DRV3 noted
    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
    [jlc_bom.csv]
2026-11-03 Baseboard rail on J9-47 is 15-17 V (user; net named 20V on the baseboard): sheet 1 note, STATUS, DRV3 alternatives incl. MIC4452YM-TR
    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
    [01_gate_drivers.kicad_sch]
2026-11-05 DCM variant gate_drive_power_dcm_fb_v3_ee10 converted in dcm/ (phases 0-4 + JLC files)
    Self-contained subproject with its own p2k_config.py, same proteus2kicad tools
    (dcm/tools/p2k -> ../../tools/p2k). Q1 MMBT3904 primary switch instead of DRV3;
    no PDF exists, so sheet 1 follows the asym board and the Q1 block is drawn from
    the IPC netlist. SOT-23 footprint on the Proteus pad positions. dcm/tools/check_all.sh:
    ALL CHECKS PASSED (43/43 parts, 135/135 IPC records, 26 nets 1:1, 0 shorts).
    Findings in dcm/README.md (R7 10k clamp, Q1 base drive, DCM windings);
    ZLLS400TA JLC stock down to 2 (open question, root STATUS.md).
    [01_gate_drivers.kicad_sch, 02_gate_supply.kicad_sch, footprint_fit.csv, footprint_pads.csv, gate_drive.kicad_pcb, gate_drive.kicad_sch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]
